adman234/radio-hardware/docs/datasheets/RV097NS_B50K_listing.webp

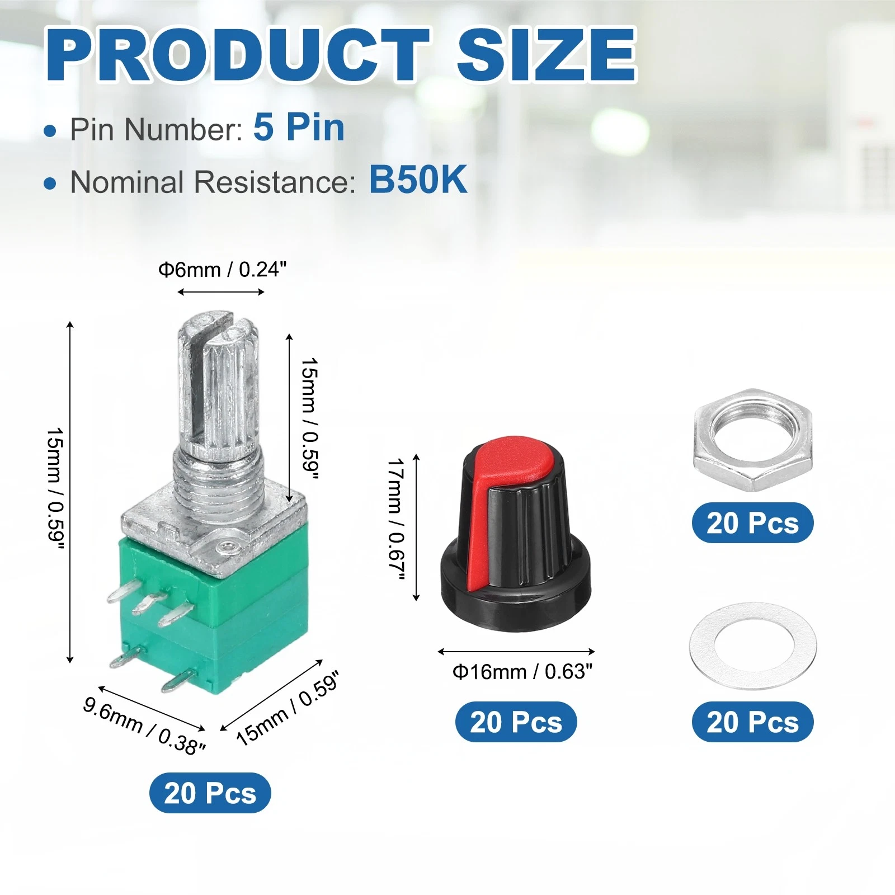
docs/datasheets/RV097NS_B50K_listing.webp
