adman234/radio-hardware/docs/img/board-bottom.png

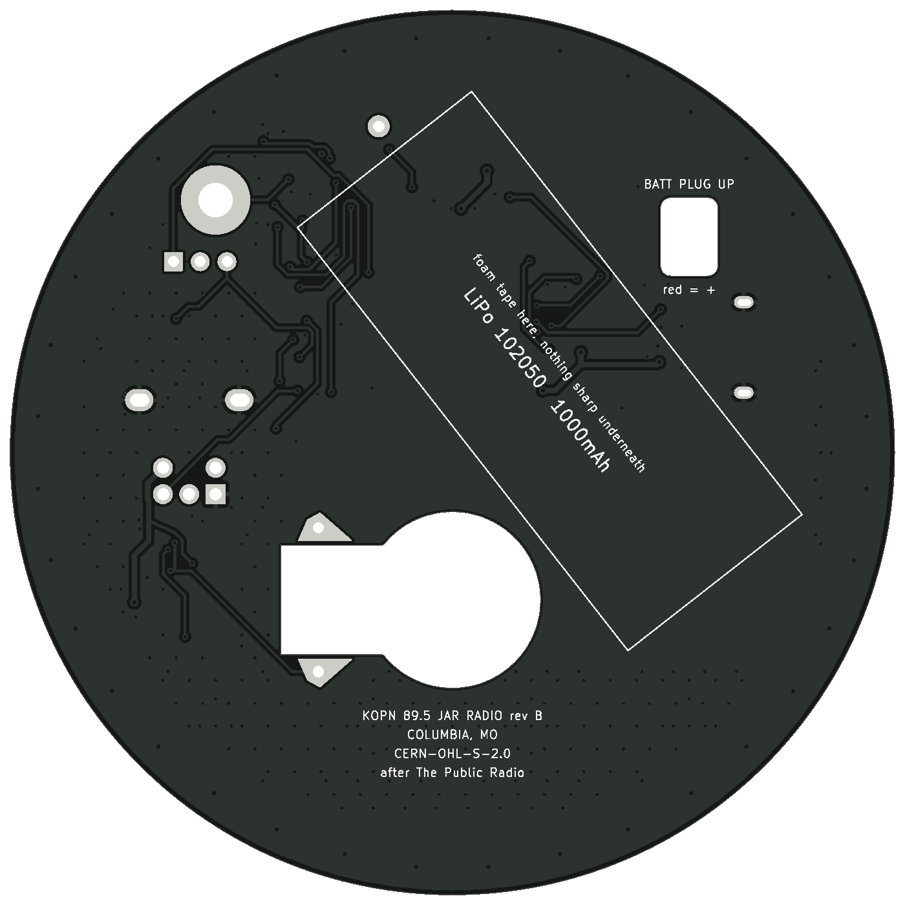
docs/img/board-bottom.png
