adman234/radio-hardware/docs/img/board-top.png

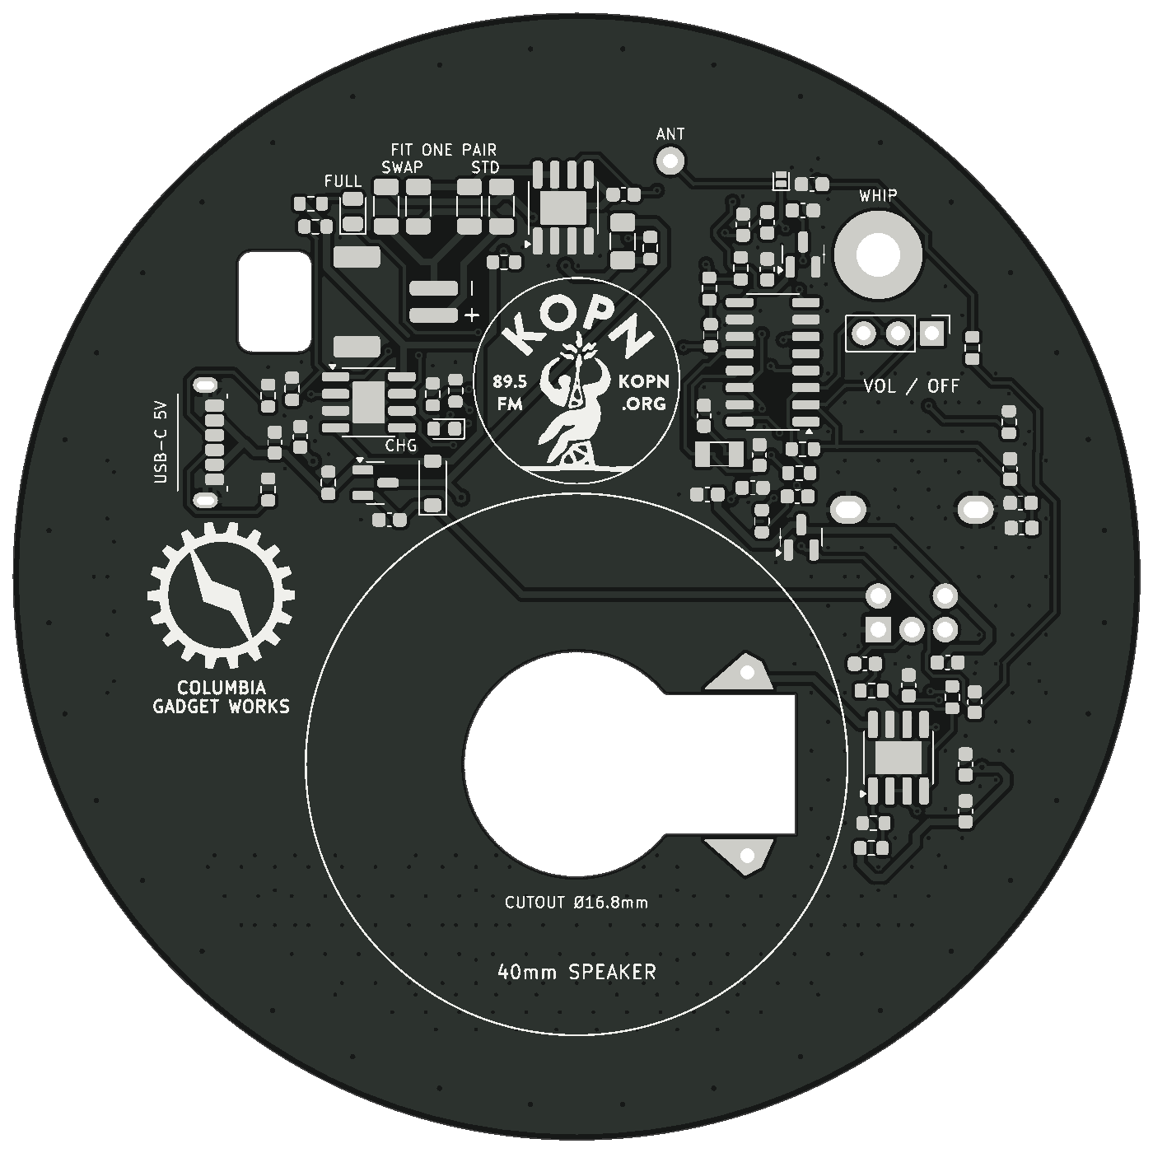
docs/img/board-top.png
