adman234/radio-hardware/docs/img/schematic.png

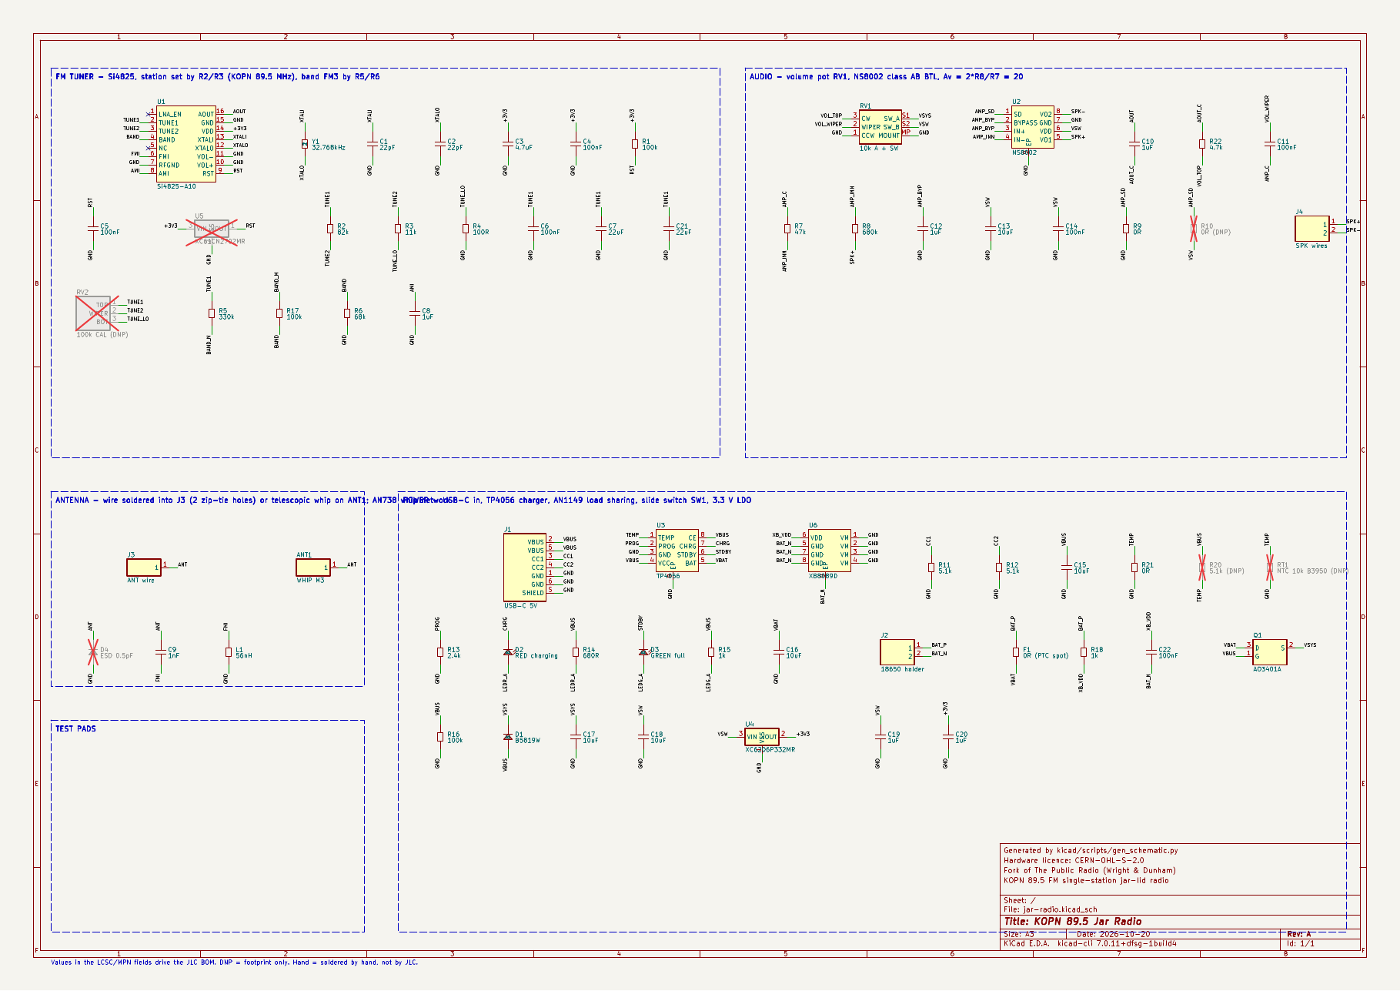
docs/img/schematic.png
