adman234/radio-hardware/docs/lcsc-bom-quote-2026-10-21.xls

LCSC_BOM_check_100pcs.csv |  |  |  |  |  |  |  |  |  | LCSC BOM Quotation
 |  |  |  |  |  |  |  |  |  | BOM Date Created：21/10/26 03:21:28 |  |  |  | BOM Export Date: 21/10/26 03:21:58 |  |  |  | The matching result is a real-time query result, availability and prices may fluctuate. Backorder items are estimated prices for your reference, please submit "Create Quote" to get the real price. All information is provided "as is" and is subject to change without notice. Any use made of the information provided is without recourse to LCSC and at the user's risk.
 |  |  |  |  |  |  |  |  |  | EST TOTAL :$384.72 |  |  |  | Website：https://www.lcsc.com/bom | https://www.lcsc.com/bom | https://www.lcsc.com/bom | https://www.lcsc.com/bom
Uploaded data |  |  |  |  |  |  |  |  |  | LCSC Matching Results
LCSC# | Mfr. | Mrf# | Description | Package | Value | Customer Part Number | Quantity | Target Price(USD) | Target Lead Time(Business Days) | Mrf# | Mfr. | Order Qty. | Unit Price(USD) | Ext.Price(USD) | LCSC# | Package | Min | Mult | SPQ | Availability | Stock Status | Customer Notes | Description | Matched status | Product Link
C1653 |  | CL10C220JB8NNNC | 22pF |  |  | - | 200 |  |  | CL10C220JB8NNNC | Samsung Electro-Mechanics | 200 | 0.0034 | 0.68 | C1653 | - | 100 | 100 | 4000 | 165800 | In Stock |  | 22pF ±5% 50V Ceramic Capacitor C0G 0603 | Exact Matches | https://uat.lcsc.com/product-detail/schottky-barrier-diodes-sbd_lge-10mq040n_C688893.html
C19702 |  | CL10A106KP8NNNC | 10uF |  |  | - | 400 |  |  | CL10A106KP8NNNC | Samsung Electro-Mechanics | 400 | 0.0111 | 4.44 | C19702 | - | 20 | 20 | 4000 | 688580 | In Stock |  | 10uF ±10% 10V Ceramic Capacitor X5R 0603 | Exact Matches
C19666 |  | CL10A475KO8NNNC | 4.7uF |  |  | - | 100 |  |  | CL10A475KO8NNNC | Samsung Electro-Mechanics | 100 | 0.0099 | 0.99 | C19666 | - | 10 | 10 | 4000 | 583760 | In Stock |  | 4.7uF ±10% 16V Ceramic Capacitor X5R 0603 | Exact Matches
C14663 |  | CC0603KRX7R9BB104 | 100nF |  |  | - | 500 |  |  | CC0603KRX7R9BB104 | YAGEO | 500 | 0.0039 | 1.95 | C14663 | - | 50 | 50 | 4000 | 7803950 | In Stock |  | 100nF ±10% 50V Ceramic Capacitor X7R 0603 | Exact Matches
C45783 |  | CL21A226MAQNNNE | 22uF |  |  | - | 300 |  |  | CL21A226MAQNNNE | Samsung Electro-Mechanics | 300 | 0.1023 | 30.69 | C45783 | - | 20 | 20 | 2000 | 993300 | In Stock |  | 22uF ±20% 25V Ceramic Capacitor X5R 0805 | Exact Matches
C15849 |  | CL10A105KB8NNNC | 1uF |  |  | - | 500 |  |  | CL10A105KB8NNNC | Samsung Electro-Mechanics | 500 | 0.0069 | 3.45 | C15849 | - | 50 | 50 | 4000 | 2529750 | In Stock |  | 1uF ±10% 50V Ceramic Capacitor X5R 0603 | Exact Matches
C163508 |  | CL10C102JB8NNNC | 1nF C0G |  |  | - | 100 |  |  | CL10C102JB8NNNC | Samsung Electro-Mechanics | 100 | 0.0039 | 0.39 | C163508 | - | 50 | 50 | 4000 | 434250 | In Stock |  | 1nF ±5% 50V Ceramic Capacitor C0G 0603 | Exact Matches
C8598 |  | B5819W SL | B5819W |  |  | - | 100 |  |  | B5819W SL | JSCJ | 100 | 0.0145 | 1.45 | C8598 | - | 20 | 20 | 3000 | 84360 | In Stock |  | Diode 40V 1A Surface Mount SOD-123 | Exact Matches
C2286 |  | KT-0603R | RED charging |  |  | - | 100 |  |  | KT-0603R | Hubei KENTO Elec | 100 | 0.0033 | 0.33 | C2286 | - | 100 | 100 | 4000 | 5804400 | In Stock |  | Red 645nm LED Indication - Discrete 2.4V 0603 | Exact Matches
C72043 |  | 19-217/GHC-YR1S2/3T | GREEN full |  |  | - | 100 |  |  | 19-217/GHC-YR1S2/3T | EVERLIGHT | 0 | 0.0304 | 0.01 | C72043 | - | 50 | 50 | 3000 | 0 | In Stock |  | Emerald Green 518nm LED Indication - Discrete 3.3V 0603 | Exact Matches
C5139344 |  | PESD5V0F1BL | ESD <=1pF |  |  | - | 100 |  |  | PESD5V0F1BL | Leiditech | 100 | 0.0269 | 2.69 | C5139344 | - | 1 | 1 | 10000 | 50 | Backordered |  | 12VC 23VC Clamp ESD DIODE DFN1006-2 | Exact Matches
C5156600 |  | TYPE-C 6PLTH6.8-DJ | USB-C 5V |  |  | - | 100 |  |  | TYPE-C 6PLTH6.8-DJ | SHOU HAN | 100 | 0.0334 | 3.34 | C5156600 | - | 10 | 10 | 1000 | 79730 | In Stock |  | USB-C (USB TYPE-C) Receptacle Connector 6 Position Surface Mount | Exact Matches
C295747 |  | S2B-PH-SM4-TB(LF)(SN) | BATT (PH) |  |  | - | 100 |  |  | S2B-PH-SM4-TB(LF)(SN) | JST | 100 | 0.1007 | 10.07 | C295747 | - | 5 | 5 | 1000 | 31450 | In Stock |  | Connector Header 2 position 2mm Pitch 2A Surface Mount, Right Angle -25℃~+85℃ | Exact Matches
C23067528 |  | GT-A2501WRS-102SBT01 | ANT (XH) |  |  | - | 100 |  |  | GT-A2501WRS-102SBT01 | G-Switch | 100 | 0.0634 | 6.34 | C23067528 | - | 5 | 5 | 700 | 700 | In Stock |  | Connector Header 2 position 2.5mm Pitch 3A Surface Mount, Right Angle -25℃~+85℃ | Exact Matches
C23067528 |  | GT-A2501WRS-102SBT01 | SPK (XH) |  |  | - | 100 |  |  | GT-A2501WRS-102SBT01 | G-Switch | 100 | 0.0634 | 6.34 | C23067528 | - | 5 | 5 | 700 | 700 | In Stock |  | Connector Header 2 position 2.5mm Pitch 3A Surface Mount, Right Angle -25℃~+85℃ | Exact Matches
C98080 |  | LQW18AN56NJ00D | 56nH |  |  | - | 100 |  |  | LQW18AN56NJ00D | muRata | 100 | 0.0462 | 4.62 | C98080 | - | 10 | 10 | 4000 | 10410 | In Stock |  | 360mA 56nH ±5% 350mΩ Unshielded Inductor 0603 Fixed Inductors RoHS | Exact Matches
C15127 |  | AO3401A | AO3401A |  |  | - | 100 |  |  | AO3401A | AOS | 100 | 0.0522 | 5.22 | C15127 | - | 5 | 5 | 3000 | 229900 | In Stock |  | 30V 4A Surface Mount SOT-23 | Exact Matches
C25803 |  | 0603WAF1003T5E | 100k |  |  | - | 200 |  |  | 0603WAF1003T5E | UNI-ROYAL | 200 | 0.0008 | 0.16 | C25803 | - | 100 | 100 | 5000 | 10163000 | In Stock |  | 100kΩ ±1% 100mW 0603 Thick Film Resistor | Exact Matches
C23186 |  | 0603WAF5101T5E | 5.1k |  |  | - | 200 |  |  | 0603WAF5101T5E | UNI-ROYAL | 200 | 0.0007 | 0.14 | C23186 | - | 100 | 100 | 5000 | 18130600 | In Stock |  | 5.1kΩ ±1% 100mW 0603 Thick Film Resistor | Exact Matches
C4211 |  | 0603WAF3001T5E | 3.0k |  |  | - | 100 |  |  | 0603WAF3001T5E | UNI-ROYAL | 100 | 0.0005 | 0.05 | C4211 | - | 100 | 100 | 5000 | 5478000 | In Stock |  | 3kΩ ±1% 100mW 0603 Thick Film Resistor | Exact Matches
C23228 |  | 0603WAF6800T5E | 680R |  |  | - | 100 |  |  | 0603WAF6800T5E | UNI-ROYAL | 100 | 0.0007 | 0.07 | C23228 | - | 100 | 100 | 5000 | 1356500 | In Stock |  | 680Ω ±1% 100mW 0603 Thick Film Resistor | Exact Matches
C4190 |  | 0603WAF2201T5E | 2.2k |  |  | - | 100 |  |  | 0603WAF2201T5E | UNI-ROYAL | 100 | 0.0005 | 0.05 | C4190 | - | 100 | 100 | 5000 | 3748700 | In Stock |  | 2.2kΩ ±1% 100mW 0603 Thick Film Resistor | Exact Matches
C861580 |  | RT0603BRD0786K6L | 86.6k 0.1% |  |  | - | 100 |  |  | RT0603BRD0786K6L | YAGEO | 100 | 0.0159 | 1.59 | C861580 | - | 20 | 20 | 5000 | 10580 | In Stock |  | 100mW 86.6kΩ 75V Thin Film Resistor ±25ppm/℃ ±0.1% 0603 Chip Resistor - Surface Mount RoHS | Exact Matches
C4553285 |  | TNPW060311K7BEEA | 11.7k 0.1% |  |  | - | 100 |  |  | TNPW060311K7BEEA | VISHAY | 100 | 0.0630 | 6.30 | C4553285 | - | 5 | 5 | 5000 | 2825 | In Stock |  | 11.7kΩ 100mW Thin Film Resistor ±25ppm/℃ ±0.1% 0603 Chip Resistor - Surface Mount RoHS | Exact Matches
C22775 |  | 0603WAF1000T5E | 100R |  |  | - | 100 |  |  | 0603WAF1000T5E | UNI-ROYAL | 100 | 0.0009 | 0.09 | C22775 | - | 100 | 100 | 5000 | 2196600 | In Stock |  | 100Ω ±1% 100mW 0603 Thick Film Resistor | Exact Matches
C25969 |  | 0603WAF4303T5E | 430k |  |  | - | 100 |  |  | 0603WAF4303T5E | UNI-ROYAL | 100 | 0.0009 | 0.09 | C25969 | - | 100 | 100 | 5000 | 90500 | In Stock |  | 430kΩ ±1% 100mW 0603 Thick Film Resistor | Exact Matches
C23231 |  | 0603WAF6802T5E | 68k |  |  | - | 100 |  |  | 0603WAF6802T5E | UNI-ROYAL | 100 | 0.0007 | 0.07 | C23231 | - | 100 | 100 | 5000 | 235700 | In Stock |  | 68kΩ ±1% 100mW 0603 Thick Film Resistor | Exact Matches
 |  | 0603WAF4702T5E | 47k |  |  | - | 100 |  |  | 0603WAF4702T5E | UNI-ROYAL | 100 | 0.0007 | 0.07 | C25819 | - | 100 | 100 | 5000 | 0 | Backordered |  | 47kΩ ±1% 100mW 0603 Thick Film Resistor | Exact Matches
 |  | 0603WAF5603T5E | 560k |  |  | - | 100 |  |  | 0603WAF5603T5E | UNI-ROYAL | 100 | 0.0006 | 0.06 | C23203 | - | 100 | 100 | 5000 | 206100 | In Stock |  | 560kΩ ±1% 100mW 0603 Thick Film Resistor | Exact Matches
C21189 |  | 0603WAF0000T5E | 0R |  |  | - | 100 |  |  | 0603WAF0000T5E | UNI-ROYAL | 100 | 0.0007 | 0.07 | C21189 | - | 100 | 100 | 5000 | 13726500 | In Stock |  | 0Ω ±1% 100mW 0603 Thick Film Resistor | Exact Matches
C470569 |  | RK0971111Z0P | 20k + SW |  |  | - | 100 |  |  | RK0971111Z0P | ALPSALPINE | 100 | 1.5486 | 154.86 | C470569 | - | 1 | 1 | 70 | 101 | In Stock |  | ±20% 50mW 20kΩ Through Hole Trimmer Potentiometers | Exact Matches
C2654605 |  | SI4825-A10-CSR | Si4825-A10 |  |  | - | 100 |  |  | SI4825-A10-CSR | SILICON LABS | 100 | 0.9890 | 98.90 | C2654605 | - | 1 | 1 | 2500 | 96 | Backordered |  | FM 504kHz~28.5MHz 2V~3.6V SOIC-16 RF Transceiver ICs RoHS | Exact Matches
C189960 |  | NS8002 | NS8002 |  |  | - | 100 |  |  | NS8002 | Shenzhen Nsiway Tech | 100 | 0.0222 | 2.22 | C189960 | - | 10 | 10 | 3000 | 16990 | In Stock |  | 6mA 3V~5.25V 1-Channel 1.8Wx1@4Ω Class AB SOP-8 Audio Amplifiers | Exact Matches
C16581 |  | TP4056-42-ESOP8 | TP4056 |  |  | - | 100 |  |  | TP4056-42-ESOP8 | TOP POWER ASIC | 100 | 0.0982 | 9.82 | C16581 | - | 5 | 5 | 4000 | 24220 | In Stock |  | Lithium Battery 1A ESOP-8 Battery Management RoHS | Exact Matches
C5446 |  | XC6206P332MR | XC6206P332MR |  |  | - | 100 |  |  | XC6206P332MR-G | TOREX | 100 | 0.0806 | 8.06 | C5446 | - | 5 | 5 | 3000 | 205090 | In Stock |  | 3.3V Positive Fixed SOT-23-3L Voltage Regulators - Linear, Low Drop Out (LDO) Regulators RoHS | Exact Matches
C112139 |  | XC61CN2702MR-G | XC61CN2702MR |  |  | - | 100 |  |  | XC61CN2702MR-G | TOREX | 100 | 0.0986 | 9.86 | C112139 | - | 5 | 5 | 3000 | 4140 | In Stock |  | 30us Active Low 700mV~10V 1 SOT-23 Supervisors RoHS | Exact Matches
C32346 |  | Q13FC13500004 | 32.768kHz |  |  | - | 100 |  |  | Q13FC13500004 | EPSON | 100 | 0.0919 | 9.19 | C32346 | - | 5 | 5 | 3000 | 353800 | In Stock |  | Crystal 32.768kHz ±20ppm 12.5pF 70kΩ SMD3215-2P | Exact Matches
