adman234/radio-hardware/docs/jlc-bom-match-2026-10-21.xlsx

JLCPCB BOM Tool - BOM Matching
BOM name：BOM-JLCPCB Assembly Order.xlsx |  |  | Download Time：2026-10-21 03:20:15 |  |  |  | * Our matching results are updated in real-time, but stock and prices may change. If it's been over 24 hours, please re-match before placing your order.
PCB Assembled Qty：5 |  |  | Est. Total Price：20.7751
Your BOM |  |  |  | Matched Parts |  |  |  |  |  |  | Order Information
Designator | Comment | Footprint | JLCPCB Part # | Matches | Part # | Manufacturer | Footprint | Description | Category | Warning | JLCPCB Part # | Product link | Lib Type | Qty | Source | Total Price ($)
C1,C2 | 22pF | C_0603_1608Metric |  | Select by System | CL10C220JB8NNNC | Samsung Electro-Mechanics | 0603 | 22pF 50V C0G ±5% 0603 Multilayer Ceramic Capacitors MLCC - SMD/SMT ROHS | Multilayer Ceramic Capacitors MLCC - SMD/SMT |  | C1653 | https://jlcpcb.com/partdetail/2005-CL10C220JB8NNNC/C1653 | Basic | 10 | 10 JLCPCB | 0.06
C3 | 4.7uF | C_0603_1608Metric |  | Select by System | CL10A475KO8NNNC | Samsung Electro-Mechanics | 0603 | 16V 4.7uF X5R ±10% 0603 Multilayer Ceramic Capacitors MLCC - SMD/SMT ROHS | Multilayer Ceramic Capacitors MLCC - SMD/SMT |  | C19666 | https://jlcpcb.com/partdetail/20375-CL10A475KO8NNNC/C19666 | Basic | 5 | 5 JLCPCB | 0.103
C4,C5,C6,C11,C14 | 100nF | C_0603_1608Metric |  | Select by System | CC0603KRX7R9BB104 | YAGEO | 0603 | 100nF 50V X7R ±10% 0603 Multilayer Ceramic Capacitors MLCC - SMD/SMT ROHS | Multilayer Ceramic Capacitors MLCC - SMD/SMT |  | C14663 | https://jlcpcb.com/partdetail/YAGEO-CC0603KRX7R9BB104/C14663 | Basic | 25 | 25 JLCPCB | 0.21
C7,C18,C21 | 22uF | C_0805_2012Metric |  | Select by System | CL21A226MAQNNNE | Samsung Electro-Mechanics | 0805 | 22uF 25V X5R ±20% 0805 Multilayer Ceramic Capacitors MLCC - SMD/SMT ROHS | Multilayer Ceramic Capacitors MLCC - SMD/SMT |  | C45783 | https://jlcpcb.com/partdetail/46786-CL21A226MAQNNNE/C45783 | Basic | 15 | 15 JLCPCB | 2.9145
C8,C10,C12,C19,C20 | 1uF | C_0603_1608Metric |  | Select by System | CL10A105KB8NNNC | Samsung Electro-Mechanics | 0603 | 1uF 50V X5R ±10% 0603 Multilayer Ceramic Capacitors MLCC - SMD/SMT ROHS | Multilayer Ceramic Capacitors MLCC - SMD/SMT |  | C15849 | https://jlcpcb.com/partdetail/16531-CL10A105KB8NNNC/C15849 | Basic | 25 | 25 JLCPCB | 0.3825
C9 | 1nFC0G | C_0603_1608Metric |  | Select by System | CL10C102JB8NNNC | Samsung Electro-Mechanics | 0603 | 1nF 50V C0G ±5% 0603 Multilayer Ceramic Capacitors MLCC - SMD/SMT ROHS | Multilayer Ceramic Capacitors MLCC - SMD/SMT |  | C163508 | https://jlcpcb.com/partdetail/174890-CL10C102JB8NNNC/C163508 | Extended | 20 | 20 JLCPCB | 0.18
C13,C15,C16,C17 | 10uF | C_0603_1608Metric |  | Select by System | CL10A106KP8NNNC | Samsung Electro-Mechanics | 0603 | 10V 10uF X5R ±10% 0603 Multilayer Ceramic Capacitors MLCC - SMD/SMT ROHS | Multilayer Ceramic Capacitors MLCC - SMD/SMT |  | C19702 | https://jlcpcb.com/partdetail/20411-CL10A106KP8NNNC/C19702 | Basic | 20 | 20 JLCPCB | 0.544
D1 | B5819W | D_SOD-123 |  | Select by System | B5819W SL | Jiangsu Changjing Electronics Technology Co., Ltd. | SOD-123 | 1A 40V 600mV@1A 9A Independent SOD-123 Schottky Diodes ROHS | Schottky Diodes |  | C8598 | https://jlcpcb.com/partdetail/9093-B5819WSL/C8598 | Basic | 5 | 5 JLCPCB | 0.1415
D2 | REDcharging | LED_0603_1608Metric |  | Select by System | KT-0603R | Hubei KENTO Elec | 0603 | -40℃~+85℃ 1.6mm x 0.8mm square LED 1.8V~2.4V 120° 20mA 300mcd 40mW 615nm~630nm 645nm Discrete Diode Red Water Clear 0603 LED Indication - Discrete ROHS | LED Indication - Discrete |  | C2286 | https://jlcpcb.com/partdetail/Hubei_KENTOElec-KT0603R/C2286 | Basic | 5 | 5 JLCPCB | 0.038
D4 | ESD<=1pF | D_SOD-882 |  | Select by System | PESD5V0F1BL | Leiditech | DFN1006-2 | 0.22pF 110W@8/20us 12V、23V 500nA 5V 6V ESD IEC 61000-4-2、IEC 61000-4-5、IEC 61000-4-4 DFN1006-2 ESD and Surge Protection (TVS/ESD) ROHS | ESD And Surge Protection (TVS/ESD) |  | C5139344 | https://jlcpcb.com/partdetail/Leiditech-PESD5V0F1BL/C5139344 | Extended | 9 | 9 JLCPCB | 0.4473
J2 | BATT(PH) | JST_PH_S2B-PH-SM4-TB_1x02-1MP_P2.00mm_Horizontal |  | Select by System | S2B-PH-SM4-TB(LF)(SN) | JST | SMD,P=2mm,卧贴 | -25℃~+85℃ 1 100V 1x2P 2 2A 2P 2mm 5.5mm 7.9mm 8.6mm Auxiliary Solder Pin Beige Copper alloy PA PH Surface Mount, Right Angle Tin UL94V-0 SMD,P=2mm,卧贴 Wire To Board Connector ROHS | Wire To Board Connector |  | C295747 | https://jlcpcb.com/partdetail/JST-S2B_PH_SM4_TB_LF_SN/C295747 | Extended | 5 | 5 JLCPCB | 1.113
L1 | 56nH | L_0603_1608Metric |  | Select by System | LQW18AN56NJ00D | Murata Electronics | 0603 | 350mΩ 360mA 56nH Unshielded Inductor ±5% 0603 Power Inductors ROHS | Power Inductors |  | C98080 | https://jlcpcb.com/partdetail/MurataElectronics-LQW18AN56NJ00D/C98080 | Extended | 9 | 9 JLCPCB | 0.7578
Q1 | AO3401A | SOT-23 |  | Select by System | AO3401A | Alpha & Omega Semicon | SOT-23 | 1 P-Channel 14nC@10V 30V 47mΩ@10V、60mΩ@4.5V、85mΩ@2.5V 4A 55pF 645pF 80pF 900mV SOT-23 MOSFETs ROHS | MOSFETs |  | C15127 | https://jlcpcb.com/partdetail/Alpha_OmegaSemicon-AO3401A/C15127 | Basic | 5 | 5 JLCPCB | 0.511
R1,R16 | 100k | R_0603_1608Metric |  | Select by System | 0603WAF1003T5E | UNI-ROYAL(Uniroyal Elec) | 0603 | -55℃~+155℃ 100kΩ 100mW 75V Thick Film Resistor ±1% ±100ppm/℃ 0603 Chip Resistor - Surface Mount ROHS | Chip Resistor - Surface Mount |  | C25803 | https://jlcpcb.com/partdetail/26546-0603WAF1003T5E/C25803 | Basic | 10 | 10 JLCPCB | 0.031
R2 | 86.6k0.1% | R_0603_1608Metric |  | Select by System | RT0603BRD0786K6L | YAGEO | 0603 | -55℃~+155℃ 100mW 75V 86.6kΩ Thin Film Resistor ±0.1% ±25ppm/℃ 0603 Chip Resistor - Surface Mount ROHS | Chip Resistor - Surface Mount |  | C861580 | https://jlcpcb.com/partdetail/YAGEO-RT0603BRD0786K6L/C861580 | Extended | 20 | 20 JLCPCB | 0.786
R3 | 11.7k0.1% | R_0603_1608Metric |  | Select by System | TNPW060311K7BEEA | Vishay Intertech | 0603 | -55℃~+155℃ 100mW 11.7kΩ Thin Film Resistor ±0.1% ±25ppm/℃ 0603 Chip Resistor - Surface Mount ROHS | Chip Resistor - Surface Mount |  | C4553285 | https://jlcpcb.com/partdetail/VishayIntertech-TNPW060311K7BEEA/C4553285 | Extended | 7 | 7 JLCPCB | 0.651
R4 | 100R | R_0603_1608Metric |  | Select by System | 0603WAF1000T5E | UNI-ROYAL(Uniroyal Elec) | 0603 | -55℃~+155℃ 100mW 100Ω 75V Thick Film Resistor ±1% ±100ppm/℃ 0603 Chip Resistor - Surface Mount ROHS | Chip Resistor - Surface Mount |  | C22775 | https://jlcpcb.com/partdetail/23502-0603WAF1000T5E/C22775 | Basic | 5 | 5 JLCPCB | 0.013
R5 | 430k | R_0603_1608Metric |  | Select by System | 0603WAF4303T5E | UNI-ROYAL(Uniroyal Elec) | 0603 | -55℃~+155℃ 100mW 430kΩ 75V Thick Film Resistor ±1% ±100ppm/℃ 0603 Chip Resistor - Surface Mount ROHS | Chip Resistor - Surface Mount |  | C25969 | https://jlcpcb.com/partdetail/26712-0603WAF4303T5E/C25969 | Extended | 20 | 20 JLCPCB | 0.076
R6 | 68k | R_0603_1608Metric |  | Select by System | 0603WAF6802T5E | UNI-ROYAL(Uniroyal Elec) | 0603 | -55℃~+155℃ 100mW 68kΩ 75V Thick Film Resistor ±1% ±100ppm/℃ 0603 Chip Resistor - Surface Mount ROHS | Chip Resistor - Surface Mount |  | C23231 | https://jlcpcb.com/partdetail/23958-0603WAF6802T5E/C23231 | Basic | 5 | 5 JLCPCB | 0.008
R7 | 47k | R_0603_1608Metric |  | Unconfirmed | 0603WAF4702T5E | UNI-ROYAL(Uniroyal Elec) | 0603 | -55℃~+155℃ 100mW 47kΩ 75V Thick Film Resistor ±1% ±100ppm/℃ 0603 Chip Resistor - Surface Mount ROHS | Chip Resistor - Surface Mount | 1.The comment (0603WAF4702T5E) of this part does not match the one (47k) provided in your BOM. Please confirm; | C25819 | https://jlcpcb.com/partdetail/26562-0603WAF4702T5E/C25819 | Basic | 0 | 0 JLCPCB | 0
R8 | 560k | R_0603_1608Metric |  | Unconfirmed | 0603WAF5603T5E | UNI-ROYAL(Uniroyal Elec) | 0603 | -55℃~+155℃ 100mW 560kΩ 75V Thick Film Resistor ±1% ±100ppm/℃ 0603 Chip Resistor - Surface Mount ROHS | Chip Resistor - Surface Mount | 1.The comment (0603WAF5603T5E) of this part does not match the one (560k) provided in your BOM. Please confirm; | C23203 | https://jlcpcb.com/partdetail/23930-0603WAF5603T5E/C23203 | Extended | 0 | 0 JLCPCB | 0
R9 | 0R | R_0603_1608Metric |  | Select by System | 0603WAF0000T5E | UNI-ROYAL(Uniroyal Elec) | 0603 | -55℃~+155℃ 0Ω 100mW 75V Thick Film Resistor ±1% 0603 Chip Resistor - Surface Mount ROHS | Chip Resistor - Surface Mount |  | C21189 | https://jlcpcb.com/partdetail/21903-0603WAF0000T5E/C21189 | Basic | 5 | 5 JLCPCB | 0.011
R11,R12 | 5.1k | R_0603_1608Metric |  | Select by System | 0603WAF5101T5E | UNI-ROYAL(Uniroyal Elec) | 0603 | -55℃~+155℃ 100mW 5.1kΩ 75V Thick Film Resistor ±1% ±100ppm/℃ 0603 Chip Resistor - Surface Mount ROHS | Chip Resistor - Surface Mount |  | C23186 | https://jlcpcb.com/partdetail/23913-0603WAF5101T5E/C23186 | Basic | 10 | 10 JLCPCB | 0.015
R13 | 3.0k | R_0603_1608Metric |  | Select by System | 0603WAF3001T5E | UNI-ROYAL(Uniroyal Elec) | 0603 | -55℃~+155℃ 100mW 3kΩ 75V Thick Film Resistor ±1% ±100ppm/℃ 0603 Chip Resistor - Surface Mount ROHS | Chip Resistor - Surface Mount |  | C4211 | https://jlcpcb.com/partdetail/4618-0603WAF3001T5E/C4211 | Basic | 5 | 5 JLCPCB | 0.012
R14 | 680R | R_0603_1608Metric |  | Select by System | 0603WAF6800T5E | UNI-ROYAL(Uniroyal Elec) | 0603 | -55℃~+155℃ 100mW 680Ω 75V Thick Film Resistor ±1% ±100ppm/℃ 0603 Chip Resistor - Surface Mount ROHS | Chip Resistor - Surface Mount |  | C23228 | https://jlcpcb.com/partdetail/23955-0603WAF6800T5E/C23228 | Basic | 5 | 5 JLCPCB | 0.0105
R15 | 2.2k | R_0603_1608Metric |  | Select by System | 0603WAF2201T5E | UNI-ROYAL(Uniroyal Elec) | 0603 | -55℃~+155℃ 100mW 2.2kΩ 75V Thick Film Resistor ±1% ±100ppm/℃ 0603 Chip Resistor - Surface Mount ROHS | Chip Resistor - Surface Mount |  | C4190 | https://jlcpcb.com/partdetail/4597-0603WAF2201T5E/C4190 | Basic | 5 | 5 JLCPCB | 0.009
U1 | Si4825-A10 | SOIC-16_3.9x9.9mm_P1.27mm |  | Select by System | SI4825-A10-CSR | SKYWORKS/SILICON LABS | SOIC-16 | 0℃~+70℃ 2V~3.6V 504kHz~28.5MHz FM Receivers SOIC-16 RF Transceiver ICs ROHS | RF Transceiver ICs |  | C2654605 | https://jlcpcb.com/partdetail/SKYWORKS_SILICONLABS-SI4825_A10CSR/C2654605 | Extended | 5 | 5 JLCPCB | 8.5625
U2 | NS8002 | SOIC-8-1EP_3.9x4.9mm_P1.27mm_EP2.41x3.3mm |  | Select by System | NS8002 | Shenzhen Nsiway Tech | SOP-8 | -40℃~+85℃ 0.1% 1 Pair Differential Inputs 1-Channel 1.8Wx1@4Ω 3V~5.25V 6mA 80dB 85dB Class AB Enable/shutdown function SOP-8 Audio Amplifiers ROHS | Audio Amplifiers |  | C189960 | https://jlcpcb.com/partdetail/Shenzhen_NsiwayTech-NS8002/C189960 | Extended | 5 | 5 JLCPCB | 0.208
U3 | TP4056 | SOIC-8-1EP_3.9x4.9mm_P1.27mm_EP2.29x3mm |  | Select by System | TP4056-42-ESOP8 | TOPPOWER(Nanjing Extension Microelectronics) | ESOP-8 | -40℃~+85℃ 1 1A 2uA 4.2V 4V~8V Charging IC Lithium Battery Support ESOP-8 Battery Management ROHS | Battery Management |  | C16581 | https://jlcpcb.com/partdetail/17264-TP4056_42ESOP8/C16581 | Extended | 5 | 5 JLCPCB | 0.9265
U4 | XC6206P332MR | SOT-23 |  | Select by System | XC6206P332MR-G | Torex Semicon | SOT-23-3L | -40℃~+85℃@(Ta) 1 1uA 200mA 3.3V 6V Fixed Over Current Protection Positive SOT-23-3L Voltage Regulators - Linear, Low Drop Out (LDO) Regulators ROHS | Voltage Regulators - Linear, Low Drop Out (LDO) Regulators |  | C5446 | https://jlcpcb.com/partdetail/TorexSemicon-XC6206P332MRG/C5446 | Basic | 5 | 5 JLCPCB | 0.7215
U5 | XC61CN2702MR | SOT-23 |  | Select by System | XC61CN2702MR-G | Torex Semicon | SOT-23 | -40℃~+85℃@(TA) 1 2.7V 30us 700mV~10V 700nA Open-drain Voltage Detector SOT-23 Supervisor and Reset ICs ROHS | Supervisor And Reset ICs |  | C112139 | https://jlcpcb.com/partdetail/TorexSemicon-XC61CN2702MRG/C112139 | Extended | 5 | 5 JLCPCB | 0.8535
Y1 | 32.768kHz | Crystal_SMD_3215-2Pin_3.2x1.5mm |  | Select by System | Q13FC13500004 | Seiko Epson | SMD3215-2P | -40℃~+85℃ 12.5pF 32.768kHz 70kΩ Crystal Oscillator ±20ppm SMD3215-2P Crystals ROHS | Crystals |  | C32346 | https://jlcpcb.com/partdetail/SeikoEpson-Q13FC13500004/C32346 | Basic | 0 | 0 JLCPCB | 0
D3 | GREENfull | LED_0603_1608Metric |  | Select by System | 19-217/GHC-YR1S2/3T | Everlight Elec | 0603 | -40℃~+85℃ 110mW 120° 199mcd 20mA 3.3V 518nm 520nm~535nm Discrete Diode Emerald Green Water Clear 0603 LED Indication - Discrete ROHS | LED Indication - Discrete |  | C72043 | https://jlcpcb.com/partdetail/EverlightElec-19_217_GHC_YR1S23T/C72043 | Extended | 20 | 0 JLCPCB | 0.478
J3 | ANT(XH) | Connector_XH-SMD_GSwitch_GT-A2501WRS-102_1x02_P2.50mm_Horizontal |  | No matches | No Part Selected
J4 | SPK(XH) | Connector_XH-SMD_GSwitch_GT-A2501WRS-102_1x02_P2.50mm_Horizontal |  | No matches | No Part Selected
