adman234/radio-hardware/docs/bom-check.csv

lcsc | mpn | refs | qty_per_board | type | stock | cost_per_board_at_5 | cost_per_board_at_50 | notes
C1653 | CL10C220JB8NNNC | C1,C2 | 2 | Basic | 1920262 | 0.0116 | 0.0116
C19702 | CL10A106KP8NNNC | C13,C15,C16,C17,C18 | 5 | Basic | 10061272 | 0.1485 | 0.11
C19666 | CL10A475KO8NNNC | C3 | 1 | Basic | 2948420 | 0.0297 | 0.0297
C14663 | CC0603KRX7R9BB104 | C4,C5,C6,C11,C14,C22 | 6 | Basic | 50349394 | 0.0846 | 0.0846
C59461 | CL10A226MQ8NRNC | C7,C21 | 2 | Basic | 7271585 | 0.0628 | 0.0628
C15849 | CL10A105KB8NNNC | C8,C10,C12,C19,C20 | 5 | Basic | 9868521 | 0.076 | 0.076
C1588 | CL10B102KB8NNNC | C9 | 1 | Basic | 6432787 | 0.009 | 0.009
C8598 | B5819W SL | D1 | 1 | Basic | 384842 | 0.0284 | 0.0284
C2286 | KT-0603R | D2 | 1 | Basic | 7858146 | 0.0077 | 0.0077
C2297 | KT-0805G | D3 | 1 | Basic | 2722958 | 0.0164 | 0.0164
C30167335 | TYPE-C 6P LTH6.8 108 | J1 | 1 | Extended | 3236 | 0.0809 | 0.0638
C7429689 | ZX-PH2.0-WT2P | J2 | 1 | Extended | 47540 | 0.044 | 0.044
C98080 | LQW18AN56NJ00D | L1 | 1 | Extended | 10908 | 0.0845 | 0.0845
C15127 | AO3401A | Q1 | 1 | Basic | 587250 | 0.1025 | 0.0828
C25803 | 0603WAF1003T5E | R1,R17,R16 | 3 | Basic | 19748113 | 0.0093 | 0.0093
C23186 | 0603WAF5101T5E | R11,R12 | 2 | Basic | 23749760 | 0.003 | 0.003
C22940 | 0603WAF2401T5E | R13 | 1 | Basic | 1272705 | 0.0026 | 0.0026
C23228 | 0603WAF6800T5E | R14 | 1 | Basic | 2203364 | 0.0021 | 0.0021
C21190 | 0603WAF1001T5E | R15,R18 | 2 | Basic | 24277749 | 0.004 | 0.004
C23254 | 0603WAF8202T5E | R2 | 1 | Basic | 1233819 | 0.0027 | 0.0027
C23162 | 0603WAF4701T5E | R22 | 1 | Basic | 19500720 | 0.0028 | 0.0028
C17888 | 1206W4F0000T5E | R23,R24,F1 | 3 | Basic | 2258418 | 0.0255 | 0.0255
C25950 | 0603WAF1102T5E | R3 | 1 | Preferred | 288633 | 0.0019 | 0.0019
C22775 | 0603WAF1000T5E | R4 | 1 | Basic | 11248464 | 0.0026 | 0.0026
C23137 | 0603WAF3303T5E | R5 | 1 | Basic | 599621 | 0.0013 | 0.0013
C23231 | 0603WAF6802T5E | R6 | 1 | Basic | 687888 | 0.0016 | 0.0016
C25819 | 0603WAF4702T5E | R7 | 1 | Basic | 1993053 | 0.0021 | 0.0021
C25822 | 0603WAF6803T5E | R8 | 1 | Preferred | 1131227 | 0.0015 | 0.0015
C21189 | 0603WAF0000T5E | R9,R21 | 2 | Basic | 24128786 | 0.0044 | 0.0044
C18213422 | R09512NS-FB15S7.0-A103-00G | RV1 | 1 | Extended | 64 | 1.9424 | 1.5015 | THT assembly
C2654605 | SI4825-A10-CSR | U1 | 1 | Extended* | 0 | 1.7125 | 1.7125 | not in jlcparts mirror; JLC BOM tool: Extended, $1.712 each (stock unknown)
C189960 | NS8002 | U2 | 1 | Extended | 20089 | 0.0417 | 0.0417
C16581 | TP4056-42-ESOP8 | U3 | 1 | Preferred | 64777 | 0.1859 | 0.1472
C5446 | XC6206P332MR | U4 | 1 | Basic | 405951 | 0.1438 | 0.1181
C79928 | XB8089D | U6 | 1 | Extended | 8791 | 0.1638 | 0.1282
C32346 | Q13FC13500004 | Y1 | 1 | Basic | 380576 | 0.1731 | 0.1366
