adman234/radio-hardware/kicad/jar-radio.kicad_pcb

## KiCad design kicad/jar-radio.kicad_pcb (2026-10-23)

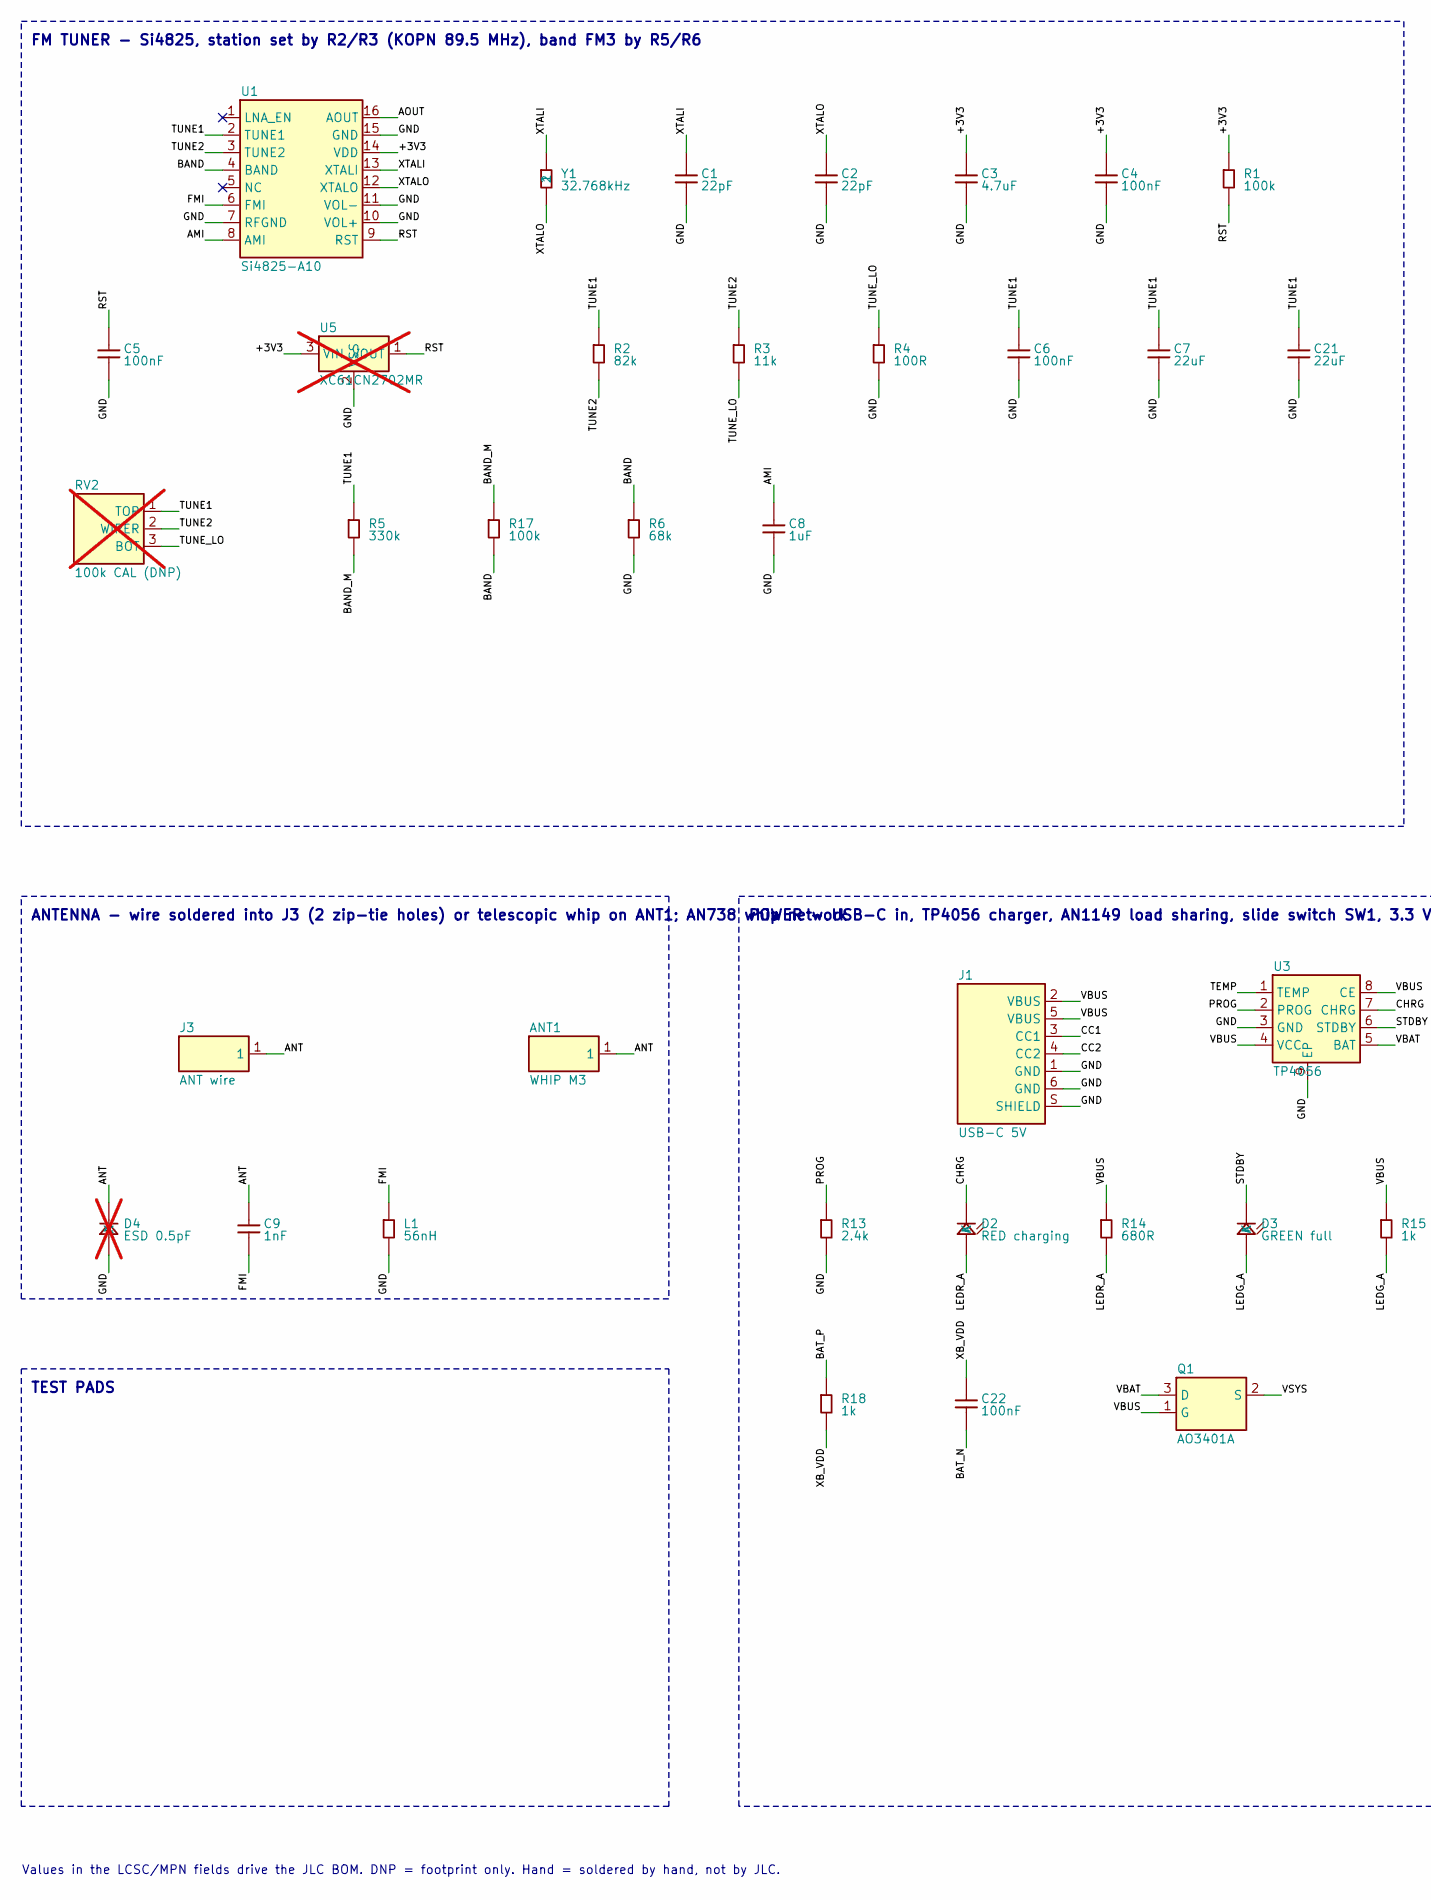
[picture p5: schematic jar-radio.kicad_sch, KOPN 89.5 Jar Radio, part in row 1, column 1]

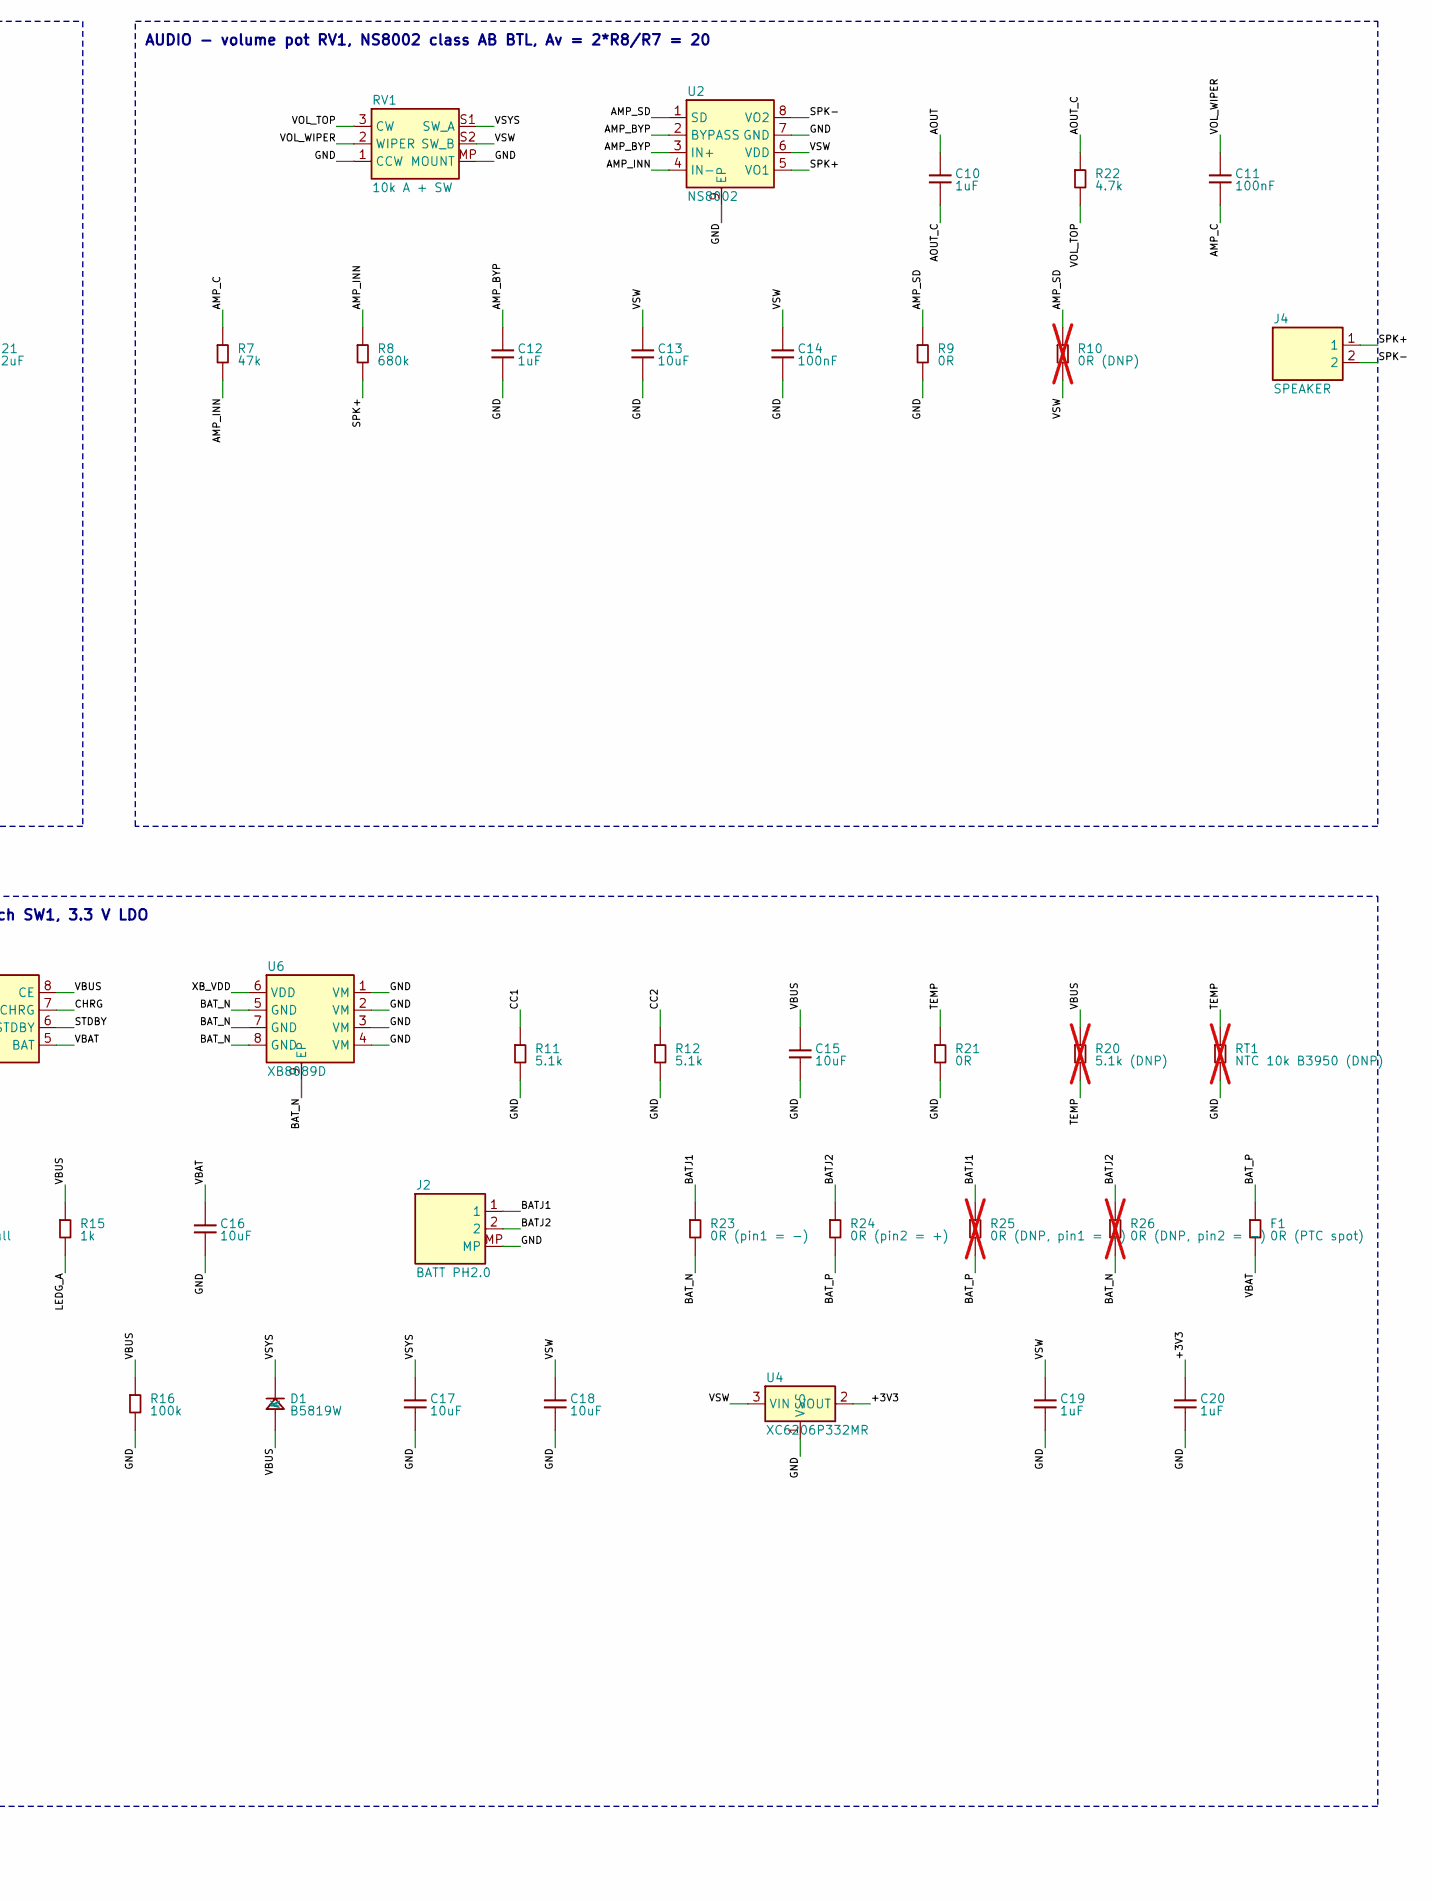
[picture p6: schematic jar-radio.kicad_sch, KOPN 89.5 Jar Radio, part in row 1, column 2]

Parts:
ANT1: WHIP M3; Antenna_Telescopic_M3
C1, C2: 22pF; C_0603_1608Metric; MPN CL10C220JB8NNNC; LCSC C1653
C3: 4.7uF; C_0603_1608Metric; MPN CL10A475KO8NNNC; LCSC C19666
C4, C5, C6, C11, C14, C22: 100nF; C_0603_1608Metric; MPN CC0603KRX7R9BB104; LCSC C14663
C7, C21: 22uF; C_0603_1608Metric; MPN CL10A226MQ8NRNC; LCSC C59461
C8, C10, C12, C19, C20: 1uF; C_0603_1608Metric; MPN CL10A105KB8NNNC; LCSC C15849
C9: 1nF; C_0603_1608Metric; MPN CL10B102KB8NNNC; LCSC C1588
C13, C15, C16, C17, C18: 10uF; C_0603_1608Metric; MPN CL10A106KP8NNNC; LCSC C19702
D1: B5819W; D_SOD-123; MPN B5819W SL; LCSC C8598
D2: RED charging; LED_0603_1608Metric; MPN KT-0603R; LCSC C2286
D3: GREEN full; LED_0805_2012Metric; MPN KT-0805G; LCSC C2297
D4: ESD 0.5pF; D_SOD-882; MPN SP3021-01ETG; LCSC C126839; not fitted
F1: 0R (PTC spot); Fuse_1206_3216Metric; MPN 1206W4F0000T5E; LCSC C17888
J1: USB-C 5V; USB_C_Receptacle_ShouHan_TYPE-C-6P-LTH6.8-108_Vertical; MPN TYPE-C 6P LTH6.8 108; LCSC C30167335
J2: BATT PH2.0; Battery_PH2.0_RightAngle_SMD_PlugCutout; MPN ZX-PH2.0-WT2P; LCSC C7429689
J3: ANT wire; Antenna_Wire_Solder_D1.0
J4: SPEAKER; Speaker_HDK-4008BB-2_TopMount; MPN HDK-4008BB-2 (C22371323, hand-soldered 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
L1: 56nH; L_0603_1608Metric; MPN LQW18AN56NJ00D; LCSC C98080
Q1: AO3401A; SOT-23; MPN AO3401A; LCSC C15127
R1, R16, R17: 100k; R_0603_1608Metric; MPN 0603WAF1003T5E; LCSC C25803
R2: 82k; R_0603_1608Metric; MPN 0603WAF8202T5E; LCSC C23254
R3: 11k; R_0603_1608Metric; MPN 0603WAF1102T5E; LCSC C25950
R4: 100R; R_0603_1608Metric; MPN 0603WAF1000T5E; LCSC C22775
R5: 330k; R_0603_1608Metric; MPN 0603WAF3303T5E; LCSC C23137
R6: 68k; R_0603_1608Metric; MPN 0603WAF6802T5E; LCSC C23231
R7: 47k; R_0603_1608Metric; MPN 0603WAF4702T5E; LCSC C25819
R8: 680k; R_0603_1608Metric; MPN 0603WAF6803T5E; LCSC C25822
R9, R21: 0R; R_0603_1608Metric; MPN 0603WAF0000T5E; LCSC C21189
R10: 0R (DNP); R_0603_1608Metric; MPN 0603WAF0000T5E; LCSC C21189; not fitted
R11, R12: 5.1k; R_0603_1608Metric; MPN 0603WAF5101T5E; LCSC C23186
R13: 2.4k; R_0603_1608Metric; MPN 0603WAF2401T5E; LCSC C22940
R14: 680R; R_0603_1608Metric; MPN 0603WAF6800T5E; LCSC C23228
R15, R18: 1k; R_0603_1608Metric; MPN 0603WAF1001T5E; LCSC C21190
R20: 5.1k (DNP); R_0603_1608Metric; MPN 0603WAF5101T5E; LCSC C23186; not fitted
R22: 4.7k; R_0603_1608Metric; MPN 0603WAF4701T5E; LCSC C23162
R23: 0R (pin1 = -); R_1206_3216Metric; MPN 1206W4F0000T5E; LCSC C17888
R24: 0R (pin2 = +); R_1206_3216Metric; MPN 1206W4F0000T5E; LCSC C17888
R25: 0R (DNP, pin1 = +); R_1206_3216Metric; MPN 1206W4F0000T5E; LCSC C17888; not fitted
R26: 0R (DNP, pin2 = -); R_1206_3216Metric; MPN 1206W4F0000T5E; LCSC C17888; not fitted
RT1: NTC 10k B3950 (DNP); R_0603_1608Metric; MPN SDNT1608X103F3950FTF; LCSC C279936; not fitted
RV1: 10k A + SW; Potentiometer_CTR_R09512NS_RearMount_Switch; MPN R09512NS-FB15S7.0-A103-00G; LCSC C18213422
RV2: 100k CAL (DNP); PinHeader_1x03_P2.54mm_Vertical; MPN 3296W-1-104; not fitted
U1: Si4825-A10; SOIC-16_3.9x9.9mm_P1.27mm; MPN SI4825-A10-CSR; LCSC C2654605
U2: NS8002; SOIC-8-1EP_3.9x4.9mm_P1.27mm_EP2.41x3.3mm; MPN NS8002; LCSC C189960
U3: TP4056; SOIC-8-1EP_3.9x4.9mm_P1.27mm_EP2.29x3mm; MPN TP4056-42-ESOP8; LCSC C16581
U4: XC6206P332MR; SOT-23; MPN XC6206P332MR; LCSC C5446
U5: XC61CN2702MR; SOT-23; MPN XC61CN2702MR-G; LCSC C112139; not fitted
U6: XB8089D; SOIC-8-1EP_3.9x4.9mm_P1.27mm_EP2.41x3.3mm; MPN XB8089D; LCSC C79928
Y1: 32.768kHz; Crystal_SMD_3215-2Pin_3.2x1.5mm; MPN Q13FC13500004; LCSC C32346

Connections:
+3V3: C3.1, C4.1, C20.1, R1.1, U1.14 (VDD), U4.2 (VOUT), U5.3 (VIN)
AMI: C8.1, U1.8 (AMI)
AMP_BYP: C12.1, U2.2 (BYPASS), U2.3 (IN+)
AMP_C: C11.2, R7.1
AMP_INN: R7.2, R8.1, U2.4 (IN-)
AMP_SD: R9.1, R10.1, U2.1 (SD)
ANT: ANT1.1, C9.1, D4.1 (K), J3.1
AOUT: C10.1, U1.16 (AOUT)
AOUT_C: C10.2, R22.1
BAND: R6.1, R17.2, U1.4 (BAND)
BAND_M: R5.2, R17.1
BATJ1: J2.1, R23.1, R25.1
BATJ2: J2.2, R24.1, R26.1
BAT_N: C22.2, R23.2, R26.2, U6.5 (GND), U6.7 (GND), U6.8 (GND), U6.9 (EP)
BAT_P: F1.1, R18.1, R24.2, R25.2
CC1: J1.3 (CC1), R11.1
CC2: J1.4 (CC2), R12.1
CHRG: D2.1 (K), U3.7 (CHRG)
FMI: C9.2, L1.1, U1.6 (FMI)
GND: C1.2, C2.2, C3.2, C4.2, C5.2, C6.2, C7.2, C8.2, C12.2, C13.2, C14.2, C15.2, C16.2, C17.2, C18.2, C19.2, C20.2, C21.2, D4.2 (A), J1.1 (GND), J1.6 (GND), J1.S (SHIELD), J2.MP, L1.2, R4.2, R6.2, R9.2, R11.2, R12.2, R13.2, R16.2, R21.2, RT1.2, RV1.1 (CCW), RV1.MP (MOUNT), U1.7 (RFGND), U1.10 (VOL+), U1.11 (VOL-), U1.15 (GND), U2.7 (GND), U2.9 (EP), U3.3 (GND), U3.9 (EP), U4.1 (VSS), U5.2 (VSS), U6.1 (VM), U6.2 (VM), U6.3 (VM), U6.4 (VM)
LEDG_A: D3.2 (A), R15.2
LEDR_A: D2.2 (A), R14.2
PROG: R13.1, U3.2 (PROG)
RST: C5.1, R1.2, U1.9 (RST), U5.1 (VOUT)
SPK+: J4.1, R8.2, U2.5 (VO1)
SPK-: J4.2, U2.8 (VO2)
STDBY: D3.1 (K), U3.6 (STDBY)
TEMP: R20.2, R21.1, RT1.1, U3.1 (TEMP)
TUNE1: C6.1, C7.1, C21.1, R2.1, R5.1, RV2.1 (TOP), U1.2 (TUNE1)
TUNE2: R2.2, R3.1, RV2.2 (WIPER), U1.3 (TUNE2)
TUNE_LO: R3.2, R4.1, RV2.3 (BOT)
VBAT: C16.1, F1.2, Q1.3 (D), U3.5 (BAT)
VBUS: C15.1, D1.2 (A), J1.2 (VBUS), J1.5 (VBUS), Q1.1 (G), R14.1, R15.1, R16.1, R20.1, U3.4 (VCC), U3.8 (CE)
VOL_TOP: R22.2, RV1.3 (CW)
VOL_WIPER: C11.1, RV1.2 (WIPER)
VSW: C13.1, C14.1, C18.1, C19.1, R10.2, RV1.S2 (SW_B), U2.6 (VDD), U4.3 (VIN)
VSYS: C17.1, D1.1 (K), Q1.2 (S), RV1.S1 (SW_A)
XB_VDD: C22.1, R18.2, U6.6 (VDD)
XTALI: C1.1, U1.13 (XTALI), Y1.1
XTALO: C2.1, U1.12 (XTALO), Y1.2

Notes on the sheet:
FM TUNER - Si4825, station set by R2/R3 (KOPN 89.5 MHz), band FM3 by R5/R6
ANTENNA - wire soldered into J3 (2 zip-tie holes) or telescopic whip on ANT1; AN738 whip network
AUDIO - volume pot RV1, NS8002 class AB BTL, Av = 2*R8/R7 = 20
POWER - USB-C in, TP4056 charger, AN1149 load sharing, slide switch SW1, 3.3 V LDO
TEST PADS
Values in the LCSC/MPN fields drive the JLC BOM. DNP = footprint only. Hand = soldered by hand, not by JLC.

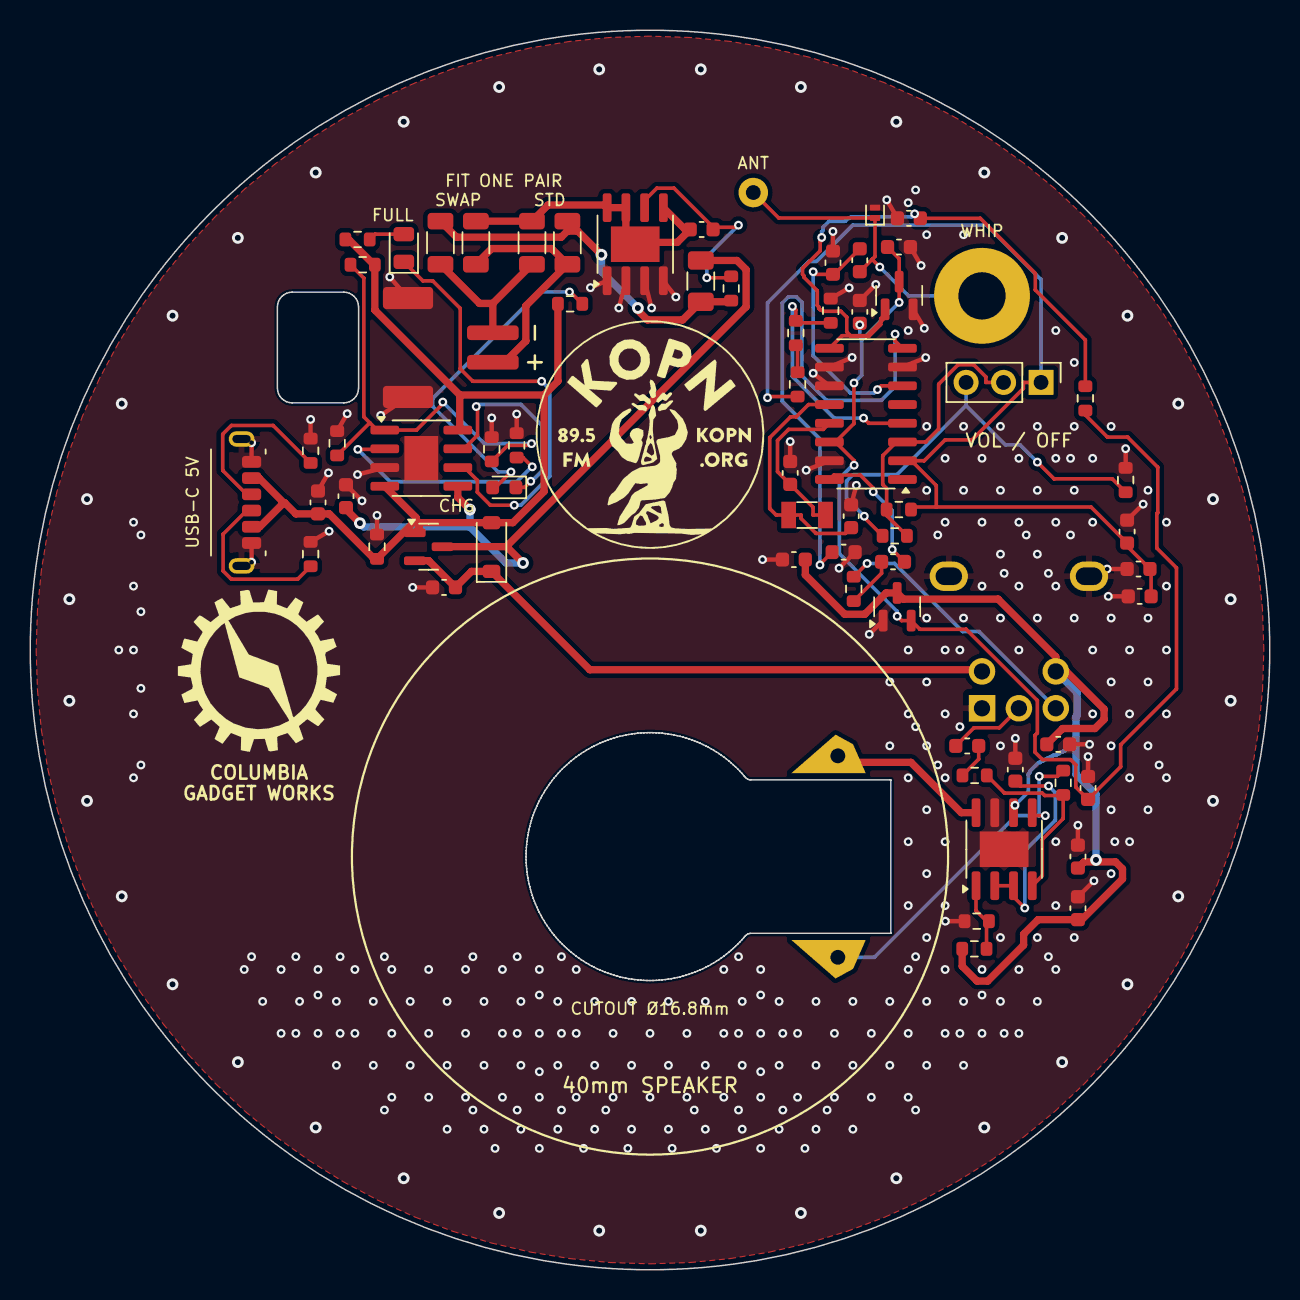
[picture p7: board jar-radio.kicad_pcb from above]

Board: 2 copper layers, 84.0 x 84.0 mm, 72 parts (1 on the bottom side), 40 nets.

Other parts of the board:
MK1: Battery_LiPo_102050_Outline
MK2: Logo_KOPN_Circle_15.5mm
MK3: Logo_CGW_11mm
