adman234/radio-hardware/(commit log)

2026-10-20 Start KiCad redesign: generator scripts and custom footprints
    Claude-Session: https://claude.ai/code/session_01UChZ4MGw6SzykNSB399iC4
2026-10-20 Plan rev B: record decisions, add quoted prices, BOM CSV and AliExpress buy list
    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
    [bom-plan.csv]
2026-10-20 Plan rev C: user-supplied LCSC parts, B50K pot and gain values, traced KOPN/CGW silkscreen logos
    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
    [bom-plan.csv]
2026-10-20 Add vendor datasheets and drawings for Si4825, AN738, NS8002, USB-C, XH connector, RV097NS pot
    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
2026-10-20 Board rev A work in progress: generated schematic, placement, routing scripts, cost model
    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
    [bom-plan.csv, jar-radio.kicad_pcb, jar-radio.kicad_sch]
2026-10-20 Speaker on PH socket, USB-C placed by JLC (two-sided), BOM/cost model/plan builder updates
    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
    [bom-plan.csv, jar-radio.kicad_pcb, jar-radio.kicad_sch]
2026-10-20 Routed board rev A (one VSW connection still open); session re-import support
    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
    [jar-radio.kicad_pcb]
2026-10-20 WIP: clear stitching vias near the open VSW connection before final route
    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
    [jar-radio.kicad_pcb]
2026-10-20 Route GND as pours with an island-via fixer
    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
    [jar-radio.kicad_sch]
2026-10-20 Pre-route locked GND stitching grid and pour-fragment joiner
    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
2026-10-20 WIP board state during reroute
    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
    [jar-radio.kicad_pcb, jar-radio.kicad_sch]
2026-10-20 Routed board (pre-stitched GND grid); 14 pour fragments still open; ignore worktrees
    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
    [jar-radio.kicad_pcb]
2026-10-20 Plan rev F: LiPo board with all parts on the top face (for review)
    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
2026-10-20 Rev F.2: Alps 20k switched pot, amp gain for 20k pot, 22uF/0603 LED swaps, XC61C pinout fix, JLC quote files
    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
    [BOM.csv, LCSC_BOM_check_100pcs.csv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]
2026-10-20 Apply JLC BOM-tool findings: Basic swaps for C9, band ladder, R8; record results
    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
    [BOM.csv, jar-radio.kicad_sch, jlc-bom-match-2026-10-21.xlsx]
2026-10-20 Record LCSC 100-pc BOM quote findings
    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
    [lcsc-bom-quote-2026-10-21.xls]
2026-10-20 Rev F.3: antenna solder hole, pot is horizontal (not usable), battery protection plan, alternatives search list
    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
    [BOM.csv, alternatives-search-list.csv, jar-radio.kicad_sch]
2026-10-20 Rev F.4: 16 oz jar, Alps switched pots are horizontal-only; pot options
    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
2026-10-20 Rev F.5: measured wide/regular jars, board geometry 84 mm, Dragonstate HDK-4008BB-2 speaker
    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
2026-10-20 Rev F.6: speaker datasheet review, 18650 holder tab-slot footprint, protection IC comparison
    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
    [BOM.csv, jar-radio.kicad_sch]
2026-10-20 Rev F.7: PTV09A-4 rear-mount pot + slide power switch, 18650 holder slot from drawing, antenna tie holes, XB8089D chosen
    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
    [BOM.csv, jar-radio.kicad_sch]
2026-10-20 Rev F.8: no connectors, holder slot 180 deg from speaker, fix VBUS-GND stub collision in schematic generator
    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
    [jar-radio.kicad_sch]
2026-10-20 Rev F.9: XB8089D + PTC protection, switched pot (CTR R097NS) replaces slide switch, SP3021 ESD, 500 mA charge, Basic green LED, local JLC parts DB + BOM checker
    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
    [bom-check.csv, jar-radio.kicad_sch]
2026-10-20 Rev F.10: USB-C C30167335 footprint, reset/ESD/PTC/NTC kept as DNP upgrade spots, pot datasheets show right-angle
    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
    [bom-check.csv, jar-radio.kicad_sch]
2026-10-20 Rev F.11: switched-pot datasheets reviewed, none vertical; propose RK09K + latching button + P-FET
    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
2026-10-20 Rev F.12: RV1 = CTR R09512NS rear-mount switched pot (C18213422), footprint from drawing, R22 4.7k + R8 680k for 10k pot
    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
    [bom-check.csv, jar-radio.kicad_sch]
2026-10-21 Rev B layout: all parts on the top face, speaker down / holder up, new grille, speaker and holder outlines (placed, routing in progress)
    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
    [jar-radio.kicad_pcb, jar-radio.kicad_sch]
2026-10-21 Board rev B: all-top-side layout routed (0 unconnected, 0 clearance), JLC gerbers/BOM/CPL, renders, maze-router + GND island fixes in the route pipeline
    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
    [BOM.csv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]
2026-10-21 Inside label: '18650 Li-ion + END TO LID' (board has XB8089D protection; protected cells may not fit the holder); re-export JLC files and renders
    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
    [jar-radio-B_Cu.gbl, jar-radio-B_Mask.gbs, jar-radio-B_Paste.gbp, jar-radio-B_Silkscreen.gbo, jar-radio-Edge_Cuts.gm1, jar-radio-F_Cu.gtl, jar-radio-F_Mask.gts, jar-radio-F_Paste.gtp]
2026-10-21 Board rev B: KOPN logo top centre clear of grille and band, render hole alignment fix, LED/+ labels, GND fan-out + generic maze joiner in the route pipeline; plan rewritten around the current design
    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
    [bom-check.csv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]
2026-10-21 Cost-down: station resistors 82k/11k 1% (fee-free), C7/C21 22uF 0603, C18 10uF 0603; re-routed (0 unconnected, 0 clearance), re-exported, plan updated
    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
    [BOM.csv, bom-check.csv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]
2026-10-22 CPL: JLC rotation corrections (SOIC/ESOP -90, SOT-23 +180) and USB-C body-centre offset, checked against JLC's assembly preview
    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
    [CPL.csv, jar-radio-B_Cu.gbl, jar-radio-B_Mask.gbs, jar-radio-B_Paste.gbp, jar-radio-B_Silkscreen.gbo, jar-radio-Edge_Cuts.gm1, jar-radio-F_Cu.gtl, jar-radio-F_Mask.gts]
2026-10-22 CPL: centre the R09512NS pot on its pads for JLC (origin was the shaft)
    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
    [CPL.csv, jar-radio-B_Cu.gbl, jar-radio-B_Mask.gbs, jar-radio-B_Paste.gbp, jar-radio-B_Silkscreen.gbo, jar-radio-Edge_Cuts.gm1, jar-radio-F_Cu.gtl, jar-radio-F_Mask.gts]
2026-10-22 Speaker top-mount: HDK-4008BB-2 soldered by its back tabs to plated pads, board cutout for cup/vents/potting; CGW logo + name on the front; outline-aware via placement; routed clean
    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
    [CPL.csv, jar-radio-B_Cu.gbl, jar-radio-B_Mask.gbs, jar-radio-B_Paste.gbp, jar-radio-B_Silkscreen.gbo, jar-radio-Edge_Cuts.gm1, jar-radio-F_Cu.gtl, jar-radio-F_Mask.gts]
2026-10-22 Speaker footprint: mirror-symmetric tab pads, symmetric block slot, cup hole down to Ø16.8
    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
2026-10-22 Re-route with the symmetric speaker pads and Ø16.8 cup hole; exports and renders regenerated
    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
    [jar-radio-B_Cu.gbl, jar-radio-B_Mask.gbs, jar-radio-B_Paste.gbp, jar-radio-B_Silkscreen.gbo, jar-radio-Edge_Cuts.gm1, jar-radio-F_Cu.gtl, jar-radio-F_Mask.gts, jar-radio-F_Paste.gtp]
2026-10-22 Battery: 102050 LiPo on a JLC-placed right-angle PH2.0 socket with a plug cutout; diagonal foam-tape outline on the inside face; XB8089D kept
    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
2026-10-22 Route the 102050/PH2.0 battery layout (0 unconnected); exports, renders, BOM check and plan regenerated
    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
    [BOM.csv, bom-check.csv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]
2026-10-22 Antenna wire hole moved up clear of the battery, strain-relief slots dropped; speaker ring labelled 40mm SPEAKER and CUTOUT Ø16.8mm
    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
2026-10-22 Battery polarity jumpers: 1206 0R crossover beside the socket (STD R23/R24 fitted, SWAP R25/R26 unfitted), labelled; legalizer keep-outs for silk labels
    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
2026-10-22 Polarity jumpers at 2.4 mm pitch (1206 courtyards no longer overlap)
    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
2026-10-22 LED labels: fall back to the nearest clear spot when all four sides are taken; jumper labels count as taken
    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
2026-10-22 Route with polarity jumpers, moved antenna hole and speaker labels (0 unconnected); exports, renders, BOM check and plan regenerated
    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
    [BOM.csv, bom-check.csv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]
2026-10-22 Plan: 30 + 30 order with real quotes and KOPN totals; quart wide-mouth jars; 75 cm internal wire antenna; venting decision
    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
2026-10-23 KOPN circle logo (from KOPN's .ai) traced to silkscreen, 15.5 mm, replaces the old KOPN wordmark
    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
2026-10-23 Route with the KOPN circle logo (0 unconnected); socket BATT label dropped (overlapped the logo ring); exports, renders, BOM check and plan regenerated
    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
    [CPL.csv, jar-radio-B_Cu.gbl, jar-radio-B_Mask.gbs, jar-radio-B_Paste.gbp, jar-radio-B_Silkscreen.gbo, jar-radio-Edge_Cuts.gm1, jar-radio-F_Cu.gtl, jar-radio-F_Mask.gts]
